Senior-Engineers/Well-Monitoring/Release_1_Well_Head_Unit/Tanzanian 1st  AWSOM installation.jpg

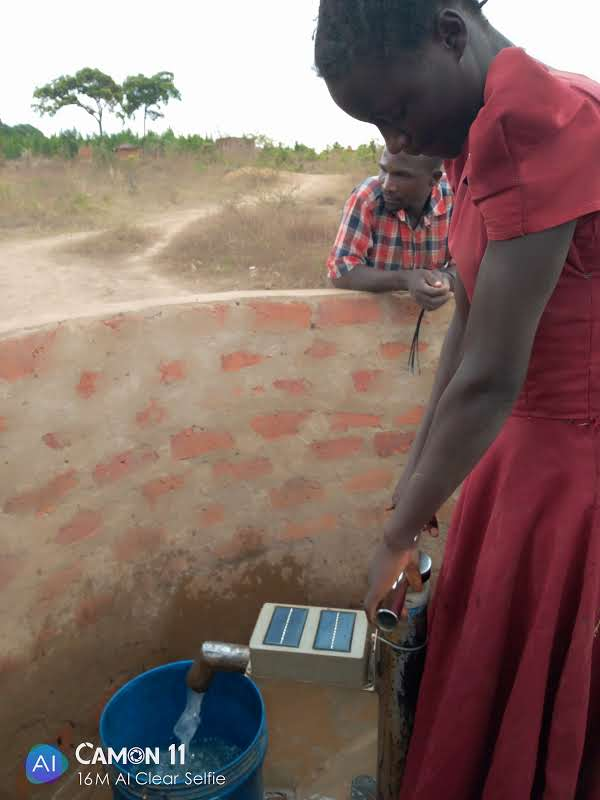
Release_1_Well_Head_Unit/Tanzanian 1st AWSOM installation.jpg
