Senior-Engineers/Well-Monitoring/Production_Base_Station/Photographs/Front_View_(Low_Res).jpg

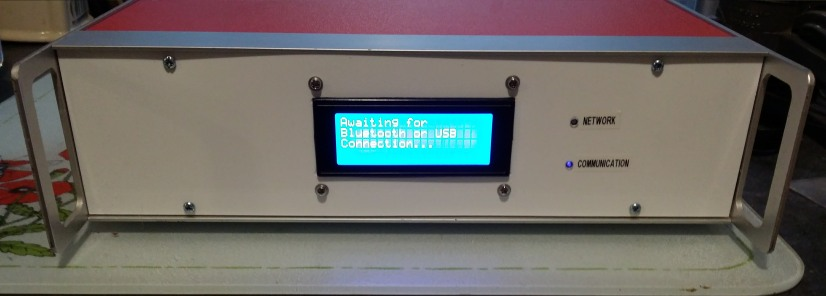
Production_Base_Station/Photographs/Front_View_(Low_Res).jpg
