Senior-Engineers/Well-Monitoring/Prototype_Base_Station/Index.pdf

Index.pdf | A list of files in this folder with a brief description
Prototype Base Station BOM.pdf | Details the "Bill of Materials" used to manufacture the Prototype Base Station
Prototype Base Station Conclusions.pdf | Details of how the development of the Prototype Base Station was completed
Prototype Base Station Design Requirement.pdf | Details of the Design Requirement
Prototype Base Station Schmatic.pdf | Details the Schematic of the Prototype Base Station
Prototype Base Station Inside.jpg | A photograph of the inside of the Case
Prototype Base Station LCD.jpg | A photograph showing the Liquid Crystal Display
Prototype Base Station Shield.jpg | A photograph of the Arduino UNO Shield showing the components
Prototype Base Station.jpg | A photograph of the Assembled Item
SMS_Master_1.5e.ino | The Arduino Sketch that controls the communication to/from the “Real World” and the SIM800L Mobile Phone Module
Stand Alone Usage Guide for Prototype Base Station.pdf | This Document outline the commands that can be sent to the “AWSOM Base Station” and the replies it returns.
