Senior-Engineers/Well-Monitoring/Release_1_Well_Head_Unit/AWSOM_Text_example.pdf

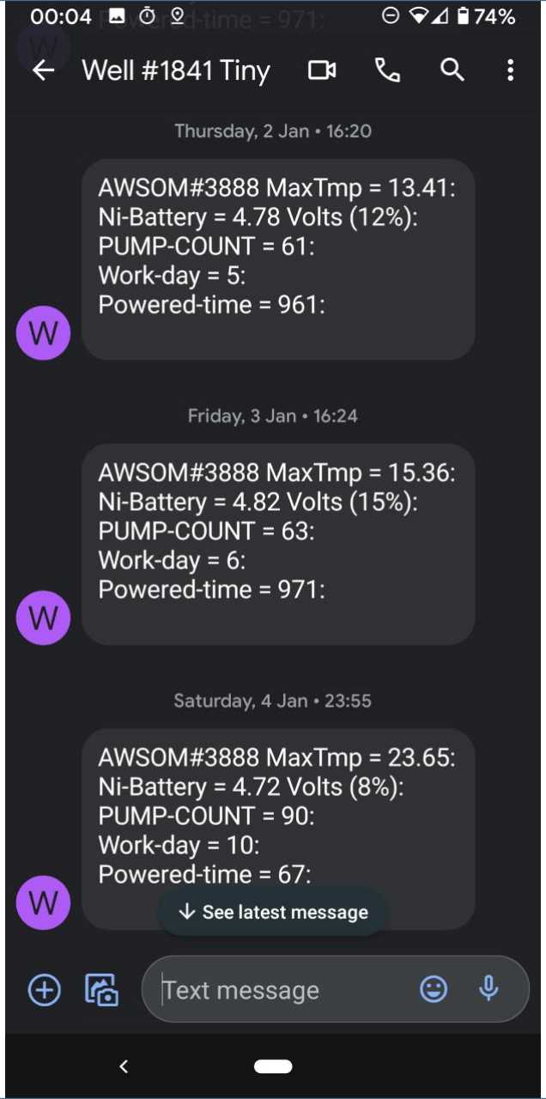
[picture p34: figure]

WellMonitoringService.co.uk | V20200517

# Texts Received from Test Well

### Notes:

- Missed 3 texts between 3rd and 4th of the month
- Reduced Powered-Time on the last text, on the 4th
- Low battery on the 4th
- High PUMP-COUNT with low Powered-Time on the 4th
- It was hot on the 4th
- The Well was checked at night on the 4th
- It was cool but sunny on the 3rd (http://www.wellmonitoringservice.co.uk/design.htm)
