Senior-Engineers/Well-Monitoring/Release_1_Well_Head_Unit/README.pdf

The files uploaded to this folder are to enable the manufacture of Release 1 of the Well Head Unit.

As part of the Sustainability Programme, it is possible to manufacture the items in Tanzania.

The PowerPoint Presentation (AWSOM Design v20200816.ppsx) provides an overview of the manufacturing process.

Please visit the Website at http://www.wellmonitoringservice.co.uk/design.htm where there are links to the YouTube Channel where you can view videos to enhance the static documents uploaded here.
