Senior-Engineers/Well-Monitoring/Release_1_Well_Head_Unit/RAW-DATA-SAMPLE.pdf

## AWSOMTM RAW DATA SELECTION 2019

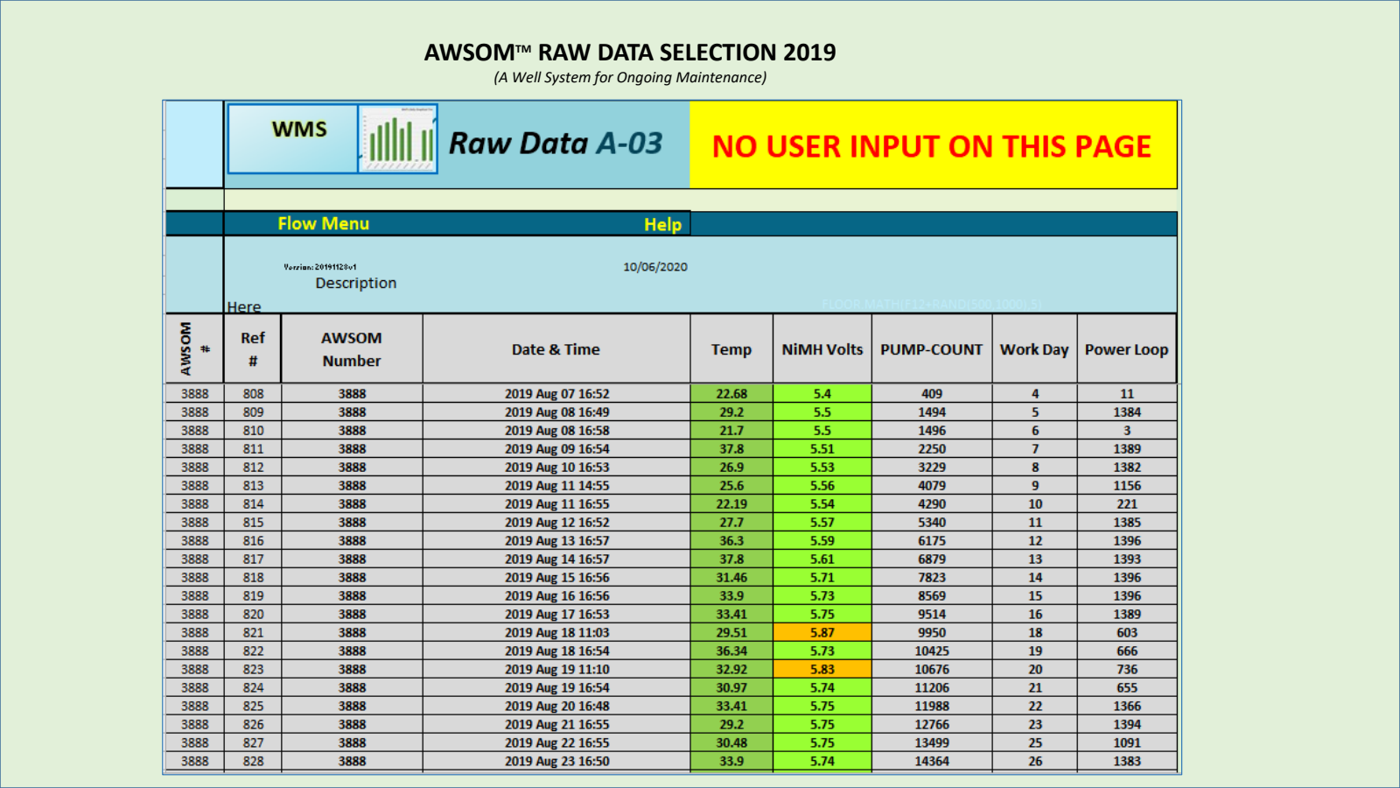
[picture p35: page 1]

(A Well System for Ongoing Maintenance)
