Senior-Engineers/Well-Monitoring/Prototype_Base_Station/Prototype Base Station Schmatic.pdf

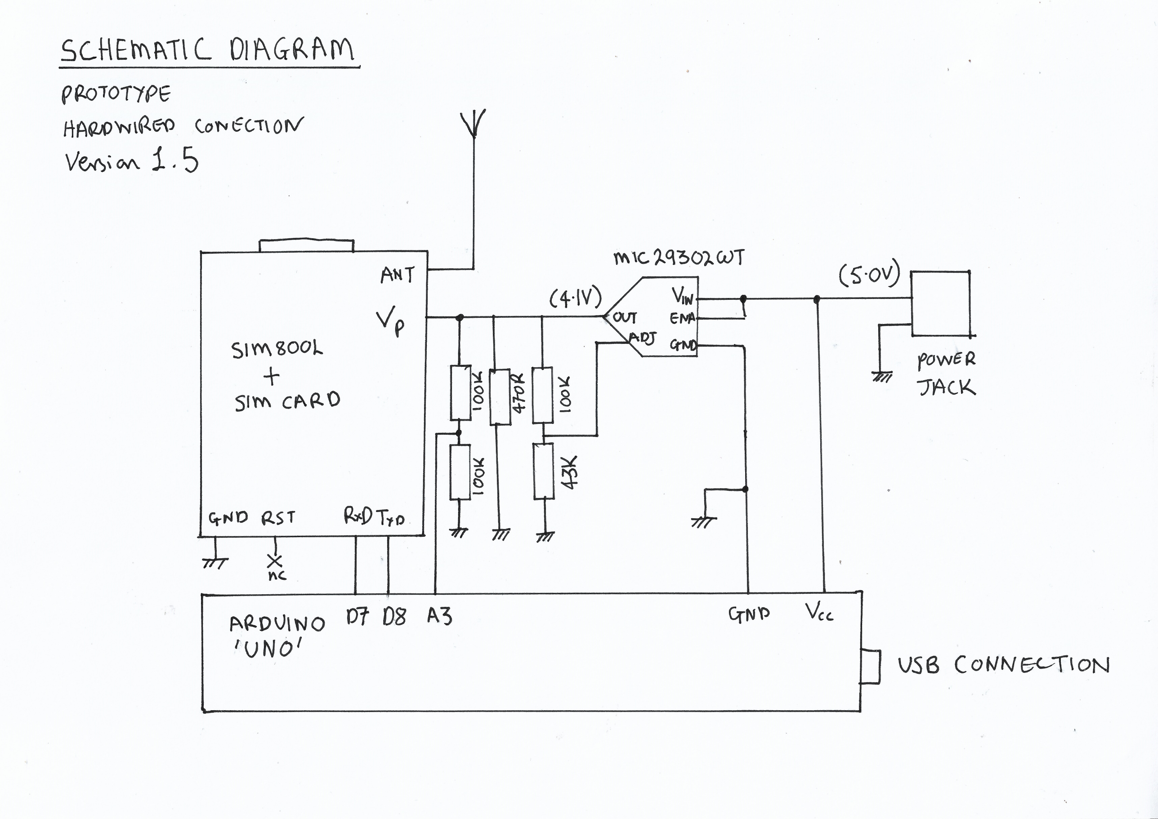
[picture p36: page 1]
