Senior-Engineers/Well-Monitoring/Production_Base_Station/Photographs/Rear_View_(Low_Res).jpg

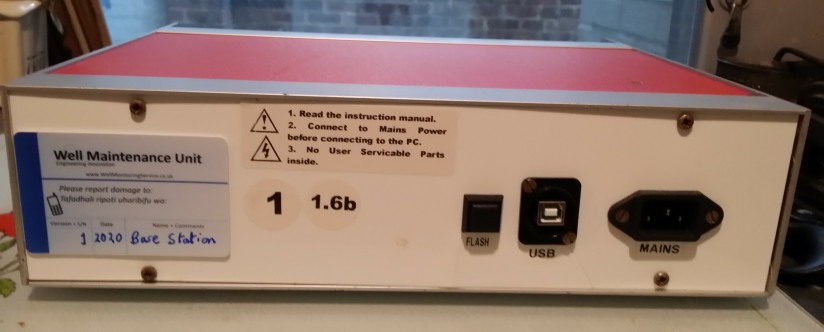
Production_Base_Station/Photographs/Rear_View_(Low_Res).jpg
