Senior-Engineers/Well-Monitoring/Prototype_Base_Station/Prototype Base Station Inside.jpg

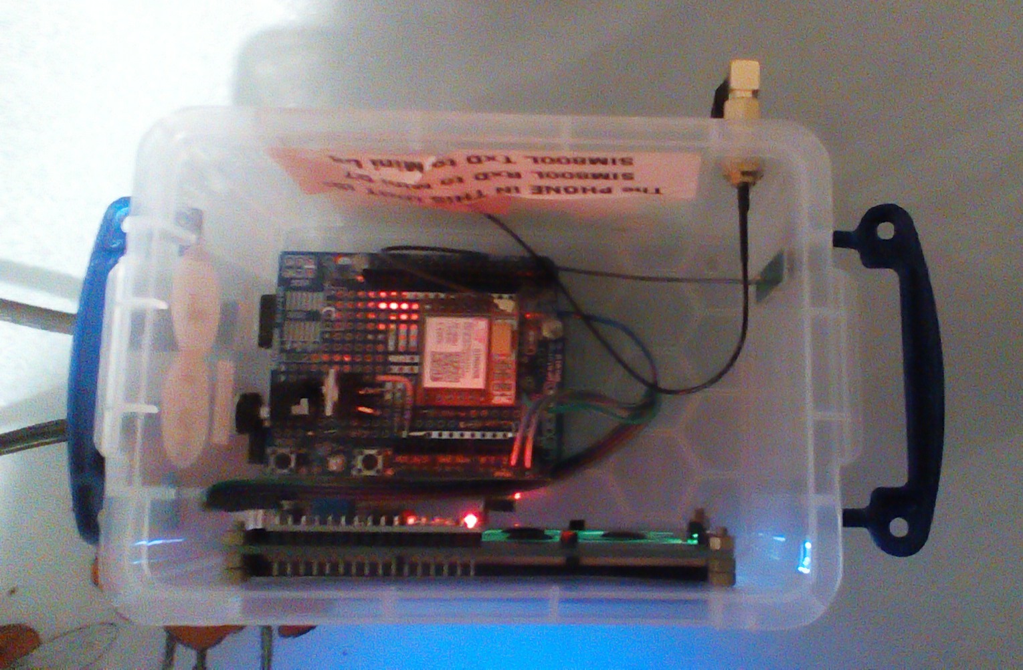
Prototype_Base_Station/Prototype Base Station Inside.jpg
