Senior-Engineers/Well-Monitoring/Prototype_Base_Station/Prototype Base Station LCD.jpg

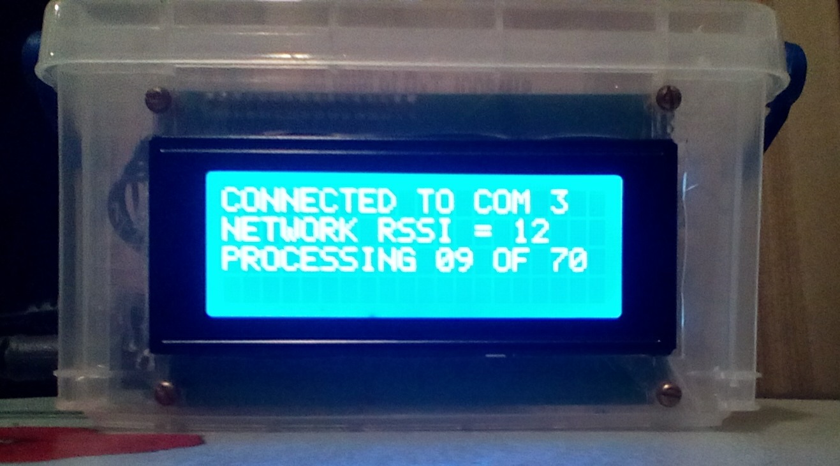
Prototype_Base_Station/Prototype Base Station LCD.jpg
