Senior-Engineers/Well-Monitoring/Prototype_Base_Station/Prototype Base Station Shield.jpg

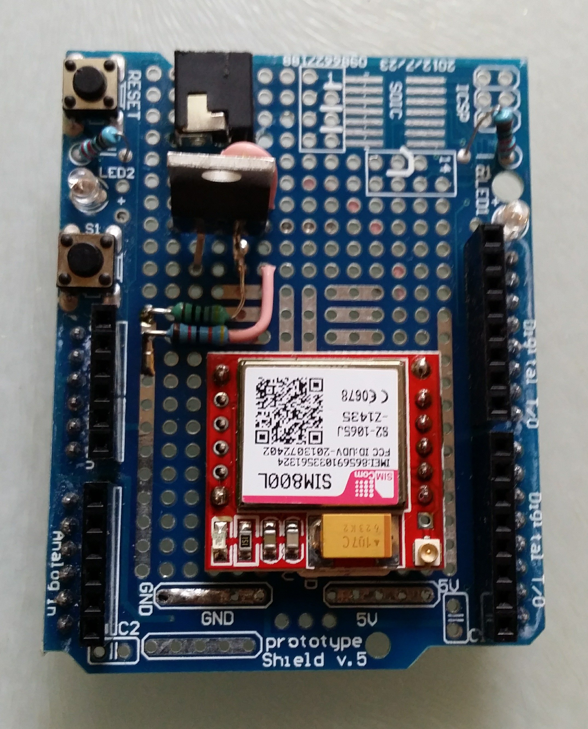
Prototype_Base_Station/Prototype Base Station Shield.jpg
