Senior-Engineers/Well-Monitoring/Prototype_Base_Station/Prototype Base Station.jpg

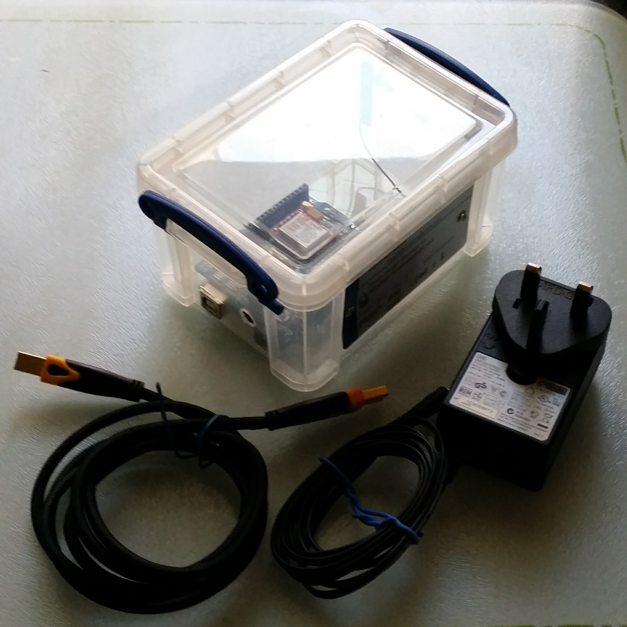
Prototype_Base_Station/Prototype Base Station.jpg
