Senior-Engineers/Well-Monitoring/Prototype_Base_Station/Prototype Base Station BOM.pdf

Ref | Description | Qty Price Each Sub Total Web link | Part No

na

Accessory Pack (Nuts; Bolts; Washers; Wire;
Solder; Glue; Paint; Conformal Coating etc.) | 1 | 5.00 £ | 5.00 £ | best guess?
X1 | Case | 1 £ | 9.75 £ | 9.75 Really Useful Box 0-7 Litre
µP1 | Arduino Module (UNO) | 1 £ 19.16 £ 19.16 Arduino UNO | RS 769-7409
µP2 | GSM GPRS Quad-Band Modules 2G | 1 £ | 9.99 £ | 9.99 SIM800L Quad-band Network Mini GPRS GSM Breakout Module: Amazon.co.uk: Electronics
PCB1 | Arduino UNO ProtoShield | 1 £ | 4.32 £ | 4.32 Arduino UNO ProtoShield
X2 | Raspberry Pi 3 (5v@2.5A) PSU | 1 £ | 7.74 £ | 7.74 Raspberry P1 3 Power Supply | RS 909-8126
X3 | Replacement Plug for X2 | 1 £ | 0.67 £ | 0.67 DC Power Plug | RS 771-9183
X4 | LED Light Pipe | 1 £ | 4.26 £ | 4.26 LED Light Pipe | RS 890-5782
CON1 | Power Connector | 1 £ | 0.26 £ | 0.26 DC power socket | RS 448-386
LCD1 | Liquid Crystal Display | 1 £ | 5.99 £ | 5.99 I2C Serial 20x4 LCD Module For Arduino UNO MEGA R3
µP3 | Voltage Regulator (MIC29302WT) | 1 £ | 1.96 £ | 1.96 Low-dropout Voltage Regulator - MIC29302WT) | RS 911-2893
R1 | Resistor 470R | 1 £ | 0.10 £ | 0.10 Through-hole Fixed Resistor 470R | RS 683-3749
R2 | Resistor 43K | 1 £ | 0.07 £ | 0.07 Through-hole Fixed Resistor 43K | RS 683-3695
R3 | Resistor 100K | 1 £ | 0.25 £ | 0.25 Vishay VR25 Series Axial Fixed Resistor 100kO ±5% 0.25W ±200ppm/°C | RS 683-5256
Component Count | 14 Cost | £ 69.52

Preffered source of components is "RS Components", then "Amazon" Prices checked at December 2020
