Senior-Engineers/Well-Monitoring/Release_1_Well_Head_Unit/AWSOM-Parts-List.pdf

| Valid up to May 2020
Required | Price (inc VAT)
Min RS
order Qty | RS Stock No. | Manuf. Part No. | Manufacturer | Description | Unit Price | Goods Value | Units
1 | 334-0424 | AGN2004H | Panasonic

### Panasonic PCB Mount Non-Latching Relay - DPDT, 4.5V dc Coil, 1A Switching Current (https://uk.rs-online.com/web/p/non-latching-relays/3340424/)

In stock for
FREE next
working day
delivery
£3.16 | £3.16 | 1 | £3.79
1 | 543-535 | 22-0239 | Vero Technologies | Vero Technologies Stripboard Cutter (https://uk.rs-online.com/web/p/stripboard-cutters/0543535/) | tools N/A | £13.89 | £13.89 | 0 | £0.00
1 | 153-3683 | BIM2006/IP-GY | RS PRO

RS PRO ABS Enclosure, IP54, Flanged, 210 x 112 x 61mm Grey (https://uk.rs-online.com/web/p/general-purpose-enclosures/1533683/)

In stock for
FREE next
working day
delivery
£11.34 | £11.34 | 1 | £13.61
1 | 917-5926 | NIMH 18670 2.4V 4A | RS PRO

### RS PRO 2.4V NiMH Rechargeable Battery Pack, 4Ah (https://uk.rs-online.com/web/p/rechargeable-battery-packs/9175926/)

2Available to
back order for
despatch
19/05/2019
£14.90 | £29.80 | 2 | £35.76
5 | 427-351 | TMP36GT9Z | Analog Devices

Analog Devices TMP36GT9Z,

### Temperature Sensor -40 → +125 °C

±3°C Voltage, 3-Pin TO-92 (https://uk.rs-online.com/web/p/temperature-sensors-humidity-sensors/0427351/)

In stock for
FREE next
working day
delivery
£1.10 | £5.51 | 1 | £1.32
1 | 488-1724 | M20-7823646 | HARWIN

### HARWIN 2.54mm Pitch 36 Way 1 Row Straight PCB Socket, Through Hole, Solder Termination (https://uk.rs-online.com/web/p/pcb-sockets/4881724/)

In stock for
FREE next
working day
delivery
£2.24 | £4.48 | 2 | £5.38
10 | 538-1433 | C322C104K5R5TA | KEMET

### KEMET 100nF Multilayer Ceramic Capacitor MLCC 50V dc ±10%

Through Hole C322C104K5R5TA (https://uk.rs-online.com/web/p/mlccs-multilayer-ceramic-capacitors/5381433/)

In stock for
FREE next
working day
delivery
£0.25 | £2.46 | 5 | £1.48
1 | 434-043 | 342

### Or 2mm thick from

E-Bay tbc (https://www.ebay.co.uk/itm/Aluminium-Sheet-1-5mm-2mm-3mm-Anodised-for-increased-durability-Satin-coloured/151707449719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)

### Natural Aluminium Sheet, 200mm Long, 2.71g/cm³, 300mm x 1.2mm (https://uk.rs-online.com/web/p/aluminium-sheets/0434043/)

In stock for
FREE next
working day
delivery
£9.83 | £9.83 | 1 | £11.80
1 | 547-3150 | M20-9993645 | HARWIN

HARWIN M20, 36 Way, 1 Row,

### Straight Pin Header (https://uk.rs-online.com/web/p/pcb-headers/5473150/)

In stock for
FREE next
working day
delivery
£1.90 | £3.80 | 2 | £4.56
1 | 918-1401 | SAS521 25ml | RS PRO

### RS PRO, 25 ml Yellow Cartridge

Acrylic Adhesive for Metal, Plastic (https://uk.rs-online.com/web/p/epoxy-resins-epoxy-adhesives/9181401/)

2Available to
back order for
despatch
04/06/2019
£10.39 | £20.78 | 2 | £24.94
1 | 494-124 | 494124 | RS PRO | RS PRO Silicone Grease 100 g Tube | N/A | £6.17 | £6.17 | 0 | N/A
1 | 292-6881 | AJB22 | CIF

### AJB22, Single-Sided Stripboard Bakelite, FR2 100 x 220 x 1.5mm (https://uk.rs-online.com/web/p/stripboards/2926881/)

In stock for
FREE next
working day
delivery
£7.60 | £7.60 | 1 | £9.12
10 | 712-7519 | AHEF100 | Littelfuse

### Littelfuse 1A Hold current, Radial

Leaded PCB Mount Resettable Fuse,

### 32V dc (https://uk.rs-online.com/web/p/resettable-wire-ended-fuses/7127519/)

In stock for
FREE next
working day
delivery
£0.32 | £3.23 | 1 | £0.39
10 | 463-274 | 1N5338BG | ON Semiconductor

### ON Semiconductor, 5.1V Zener Diode 5% 5 W Through Hole 2-Pin DO-15 (https://uk.rs-online.com/web/p/zener-diodes/0463274/)

In stock for
FREE next
working day
delivery
£0.27 | £2.74 | 2 | £0.66
5 | 189-6010 | 1757019 | Phoenix Contact

### Phoenix Contact, MSTB 2.5/2-5.08 PCB Terminal Block (https://uk.rs-online.com/web/p/pcb-terminal-blocks/1896010/)

In stock for
FREE next
working day
delivery
£1.48 | £7.41 | 2 | £3.56
5 | 189-6199 | 1755736 | Phoenix Contact

### Phoenix Contact, MSTBVA 2.5/ 2-G-5.08, 2 Way, 1 Row, Straight PCB Header (https://uk.rs-online.com/web/p/pcb-headers/1896199/)

In stock for
FREE next
working day
delivery
£0.49 | £2.47 | 2 | £1.19
100 | 914-1945 | A4MM203 010RS | RS PRO

RS PRO, M3 Countersunk Head,

### 10mm Stainless Steel Pozidriv A4 316 (https://uk.rs-online.com/web/p/machine-screws/9141945/)

1Available to
back order for
despatch
24/06/2019
£0.05 | £4.56 | 10 | £0.55
1 | 534-4939 | LP2950CZ-5.0/NOPB | Texas Instruments

### Texas Instruments LP2950CZ-5.0/NOPB, LDO Regulator, 100mA, 5

V, ±0.5% 3-Pin, TO-92 (https://uk.rs-online.com/web/p/low-dropout-voltage-regulators/5344939/)

In stock for
FREE next
working day
delivery
£2.02 | £2.02 | 1 | £2.42
1 | 813-2940 | SKT370-180-100 | ABB

### ABB, Spec-Kon Series Natural Nylon Cable Tie, 370mm x 3.6 mm (https://uk.rs-online.com/web/p/cable-ties/8132940/)

Available to
back order for
despatch when
stock is
available
£9.17 | £9.17 | 1 | £11.00
1 | 528-624 | SA6 | CAMDENBOSS

### CAMDENBOSS 210 x 110 x 60mm Gasket for use with 2000 Lugged IP65 Case (https://uk.rs-online.com/web/p/enclosure-accessories/0528624/)

In stock for
FREE next
working day
delivery
£1.29 | £1.29 | 1 | £1.55
50 | 700-0909 | SB160-E3/54 | Vishay

### Vishay 60V 1A, Schottky Diode, 2-

Pin DO-204AL SB160-E3/54 (https://uk.rs-online.com/web/p/rectifier-diodes-schottky-diodes/7000909/)

In stock for
FREE next
working day
delivery
£0.20 | £10.10 | 5 | £1.21
10 | 707-7745 | RS-Carbon-10k-5%-
0.25W | RS PRO

### RS PRO 10kΩ 0.25W Carbon Film Resistor ±5% (https://uk.rs-online.com/web/p/through-hole-fixed-resistors/7077745/)

In stock for
FREE next
working day
delivery
£0.11 | £1.08 | 1 | £0.13
20 | 707-7824 | RS-Carbon-100k-5%-
0.25W | RS PRO

### RS PRO 100kΩ 0.25W Carbon Film Resistor ±5% (https://uk.rs-online.com/web/p/through-hole-fixed-resistors/7077824/)

In stock for
FREE next
working day
delivery
£0.12 | £2.44 | 5 | £0.73
1 | Contingency | ano | misc | £10.00 | £10.00 | £10.00
1 | ebay | Computer | Arduino pro mini 5v 16MHz (https://www.ebay.co.uk/itm/Pro-Mini-Arduino-compatible-5V-16-Mhz-compatible-multipacks-UK-Seller/322491053190) | 5 days | £3.40 | £3.40 | 1 | £3.40
1 | ebay | Radar | Radar module RCWL-0516 (https://www.ebay.co.uk/itm/Microwave-Radar-Sensor-RCWL-0516-Switch-Module-Human-Induction-Arduino-PI/273010174370) | 3 days | £3.75 | £3.75 | 1 | £3.75
1 | ebay | Voltage Regulator

### Buck boost Regulator Module LM2596 3v-35v (https://www.ebay.co.uk/sch/i.html?_from=R40&_sacat=0)

| | | | | 60 days | £4.56 | £4.06 | 1 | £4.56
1 | ebay | Phone module | SIM800l Module with antenna UK (https://www.ebay.co.uk/itm/SIM800L-Module-With-Antenna-GSM-GPRS-SMS-For-Arduino-Raspberry-Pi-ESP-12-UK/263168705919) | | 3 days | £4.46 | £4.46 | 1 | £4.46
1 | ebay | Solar cells | 6v solar cells 90mm x 60mm (https://www.ebay.co.uk/sch/i.html?_osacat=0&_from=R40&_nkw=Solar+Panel+Module+Model%3A90X60mm+6V&_sacat=0) | variable | 48 days | £8.18 | £8.18 | 2 | £16.36
| | | | | | Total purchased | £199.18
1 | DHL | Shipping | Shipping (N/A Hand Carried) | | n/a | £59.00 | 'Hand carried' | 0 | £0.00

£177.66

Availability

# AWSOM Well Maintenance Unit Costed Parts List

Contact Details
andrewainger@hotmail.com
01582 469973
Product List

## (Pro-Rata) ORDER COSTS TOTAL:
