Senior-Engineers/Well-Monitoring/Release_1_Well_Head_Unit/AWSOM-Cct_DDiag.pdf

# AWSOMTM CIRCUIT DIAGRAM

## (A Well System for Ongoing Maintenance)

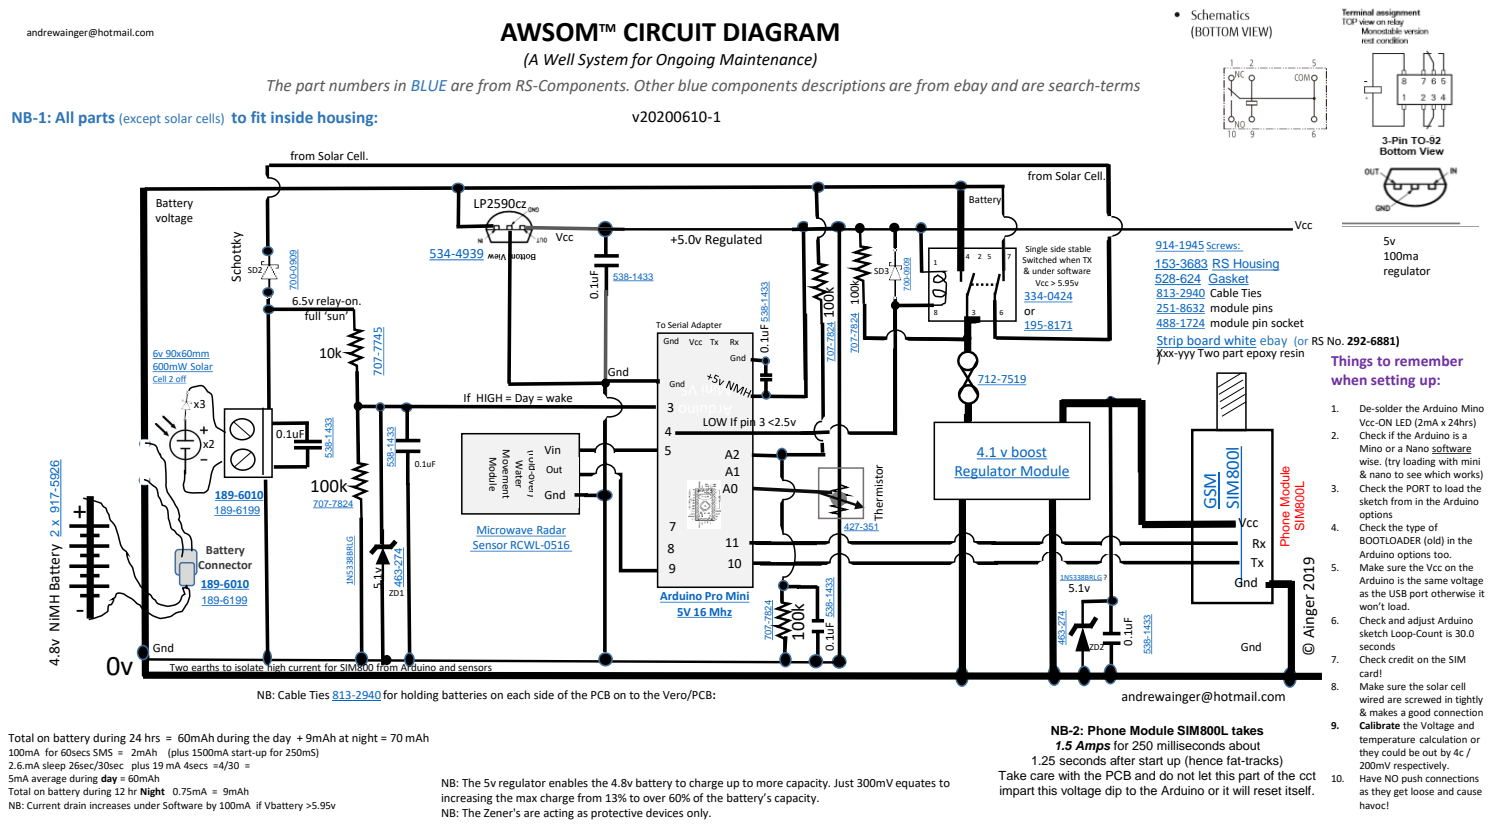
[picture p43: page 1]
4.8v NiMH Battery; (fold-over); Water; Movement; Module; Vin; Out; Gnd; GSM; SIM800l; Vcc; Thermistor; Battery voltage; LOW If pin 3 <2.5v; Battery; Out+; Battery Connector; 6v 90x60mm 600mW Solar Cell 2 off; +5.0v Regulated; Schottky; Microwave Radar Sensor RCWL-0516; The part numbers in BLUE are from RS-Components. Other blue components descriptions are from ebay and are search-terms 5.1v; 1N5338BRLG ?; 1N5338BRLG; © Ainger 2019; 6.5v relay-on. full ‘sun’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

andrewainger@hotmail.com

NB-1: All parts (except solar cells) to fit inside housing:

from Solar Cell.

914-1945 (https://uk.rs-online.com/web/p/machine-screws/9141945/?searchHistory={"enabled":true}) Screws: (https://uk.rs-online.com/web/p/machine-screws/9141945/?searchHistory={"enabled":true})
153-3683 RS Housing (https://uk.rs-online.com/web/p/general-purpose-enclosures/1533683/?searchTerm=153-3683)
528-624 (http://uk.rs-online.com/web/search/searchBrowseAction.html?method=searchProducts&searchTerm=528-624) Gasket (http://uk.rs-online.com/web/search/searchBrowseAction.html?method=searchProducts&searchTerm=528-624)
813-2940 (https://uk.rs-online.com/web/p/cable-ties/8132940/) Cable Ties
251-8632 (https://uk.rs-online.com/web/p/pcb-headers/2518632/?searchHistory={"enabled":true}) module pins
488-1724 (https://uk.rs-online.com/web/p/pcb-sockets/4881724/?searchHistory={"enabled":true}) module pin socket
Strip board white (https://www.ebay.co.uk/itm/Copper-stripboard-100-x-250mm-35-strip-x-97-hole-prototype-vero-board-CIC-21-119/114196166702) ebay (or RS No. 292-6881)
Xxx-yyy Two part epoxy resin

To Serial Adapter
Vcc

Things to remember
when setting up:

If HIGH = Day = wake

1. De-solder the Arduino Mino
Vcc-ON LED (2mA x 24hrs)
2. Check if the Arduino is a
Mino or a Nano software
wise. (try loading with mini
& nano to see which works)
3. Check the PORT to load the
sketch from in the Arduino
options
4. Check the type of
BOOTLOADER (old) in the

Arduino options too.
5. Make sure the Vcc on the
Arduino is the same voltage
as the USB port otherwise it
won’t load.
6. Check and adjust Arduino
sketch Loop-Count is 30.0
seconds
7. Check credit on the SIM
card!
8. Make sure the solar cell
wired are screwed in tightly
& makes a good connection
9. Calibrate the Voltage and
temperature calculation or
they could be out by 4c /
200mV respectively.
10. Have NO push connections
as they get loose and cause
havoc!

Arduino Pro Mini
5V 16 Mhz (https://www.ebay.co.uk/sch/i.html?_from=R40&_nkw=Arduino+Pro+Mini+5V+16+Mhz&_sacat=0)

Two earths to isolate high current for SIM800 from Arduino and sensors

NB: Cable Ties 813-2940 (https://uk.rs-online.com/web/p/cable-ties/8132940/) for holding batteries on each side of the PCB on to the Vero/PCB:

Total on battery during 24 hrs = 60mAh during the day + 9mAh at night = 70 mAh
100mA for 60secs SMS = 2mAh (plus 1500mA start-up for 250mS)
2.6.mA sleep 26sec/30sec plus 19 mA 4secs =4/30 =
5mA average during day = 60mAh
Total on battery during 12 hr Night 0.75mA = 9mAh
NB: Current drain increases under Software by 100mA if Vbattery >5.95v

NB-2: Phone Module SIM800L takes
1.5 Amps for 250 milliseconds about
1.25 seconds after start up (hence fat-tracks)
Take care with the PCB and do not let this part of the cct
impart this voltage dip to the Arduino or it will reset itself. (https://www.ebay.co.uk/itm/Smallest-SIM800L-GPRS-GSM-Phone-Module-Card-Board-Quad-band-Onboard-Antenna/301896039033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)

NB: The 5v regulator enables the 4.8v battery to charge up to more capacity. Just 300mV equates to
increasing the max charge from 13% to over 60% of the battery’s capacity.
NB: The Zener's are acting as protective devices only.
