Senior-Engineers/Well-Monitoring/Release_1_Well_Head_Unit/AWSOM-layout.pdf

# Well Maintenance Unit

# VERO BOARD Layout v20200607

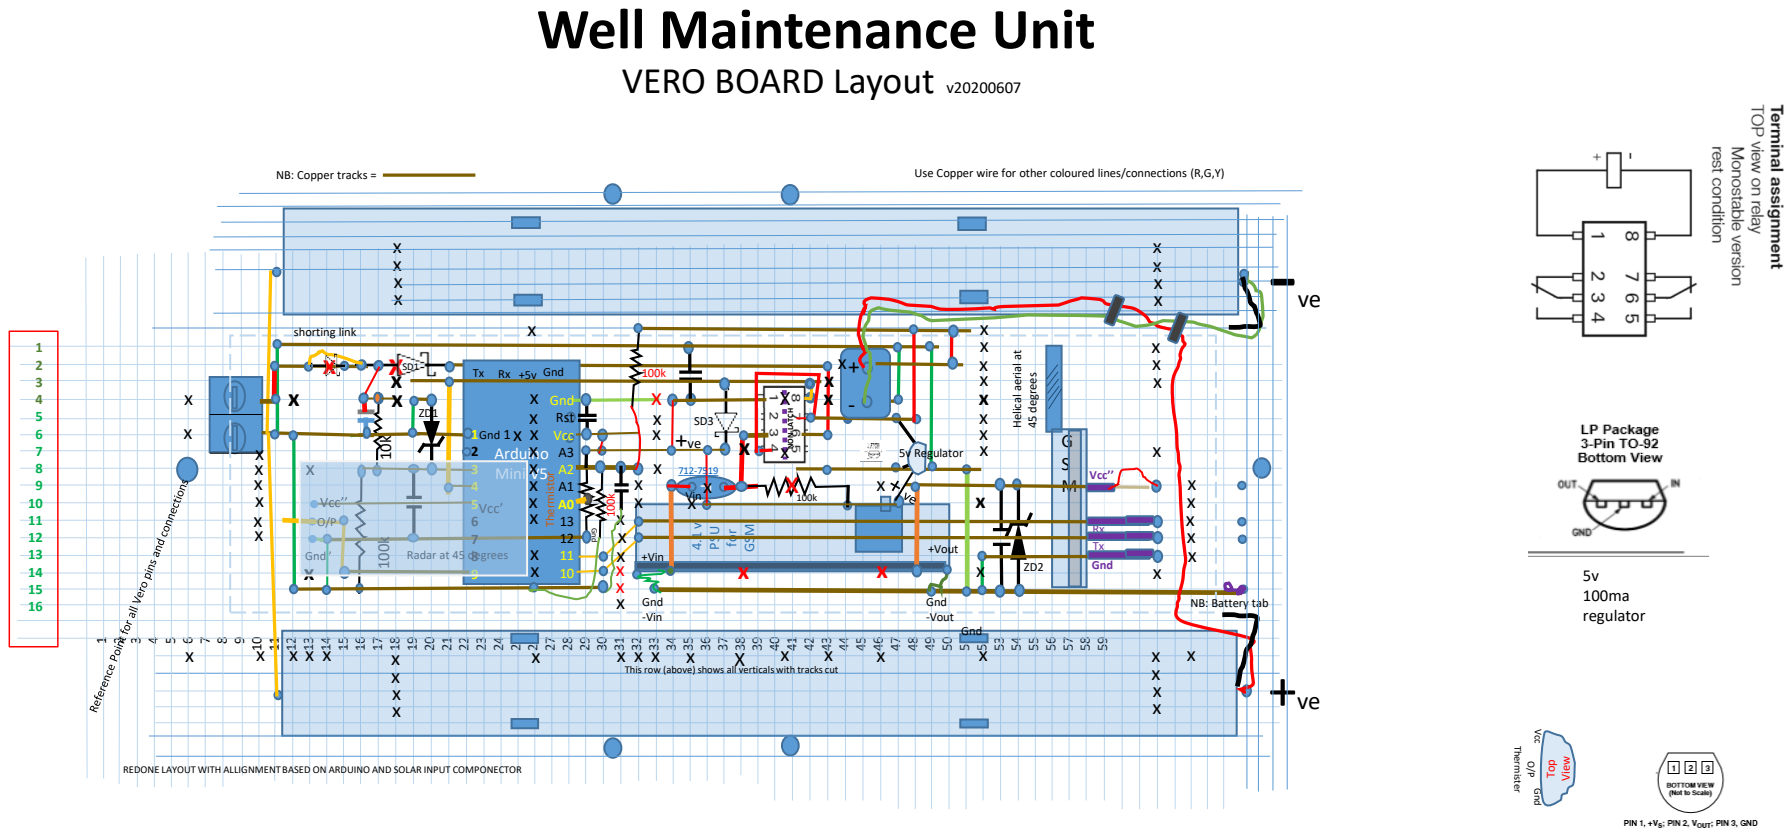
[picture p44: page 1]
PSU; for; GSM; NON-LATCH; +Vout +Vin; Gnd; Gnd -Vin; Gnd -Vout; Gnd O/P Vcc; Thermister; Top; View; 5v 100ma regulator; 45 degrees; Thermistor

NB: Copper tracks =

Use Copper wire for other coloured lines/connections (R,G,Y)

shorting link | x | | | x x x | SD1 | | | x | | | | | | | | | x | + - | 5v Regulator | | x x x x x x x | G S M | Vcc’’ | x x x x x | x | x x

Helical aerial at

x Vcc’’ O/P Gnd ’ | | | 1 Gnd 1 2 3 Vcc’ | Arduino Mini V5 | Rx | +5v x x x x x x x x x | Gnd Tx x x | Gnd Rst Vcc A3 A2 A1 A0 13 12 11 10 | 100k x x x | x | SD3 ZD1 F | x Gnd | X | x 100k | x | x

+ve 712-7519 (https://uk.rs-online.com/web/p/resettable-wire-ended-fuses/7127519/?searchTerm=712-7519)

x x | x

Radar at 45 degrees | 4 5 6 7 8 9

Vin | x | x

x | ZD2 | Rx Tx Gnd

NB: Battery tab

This row (above) shows all verticals with tracks cut

REDONE LAYOUT WITH ALLIGNMENT BASED ON ARDUINO AND SOLAR INPUT COMPONECTOR
