Senior-Engineers/Well-Monitoring/Release_1_Well_Head_Unit/BOARD-DIMENTIONS.pdf

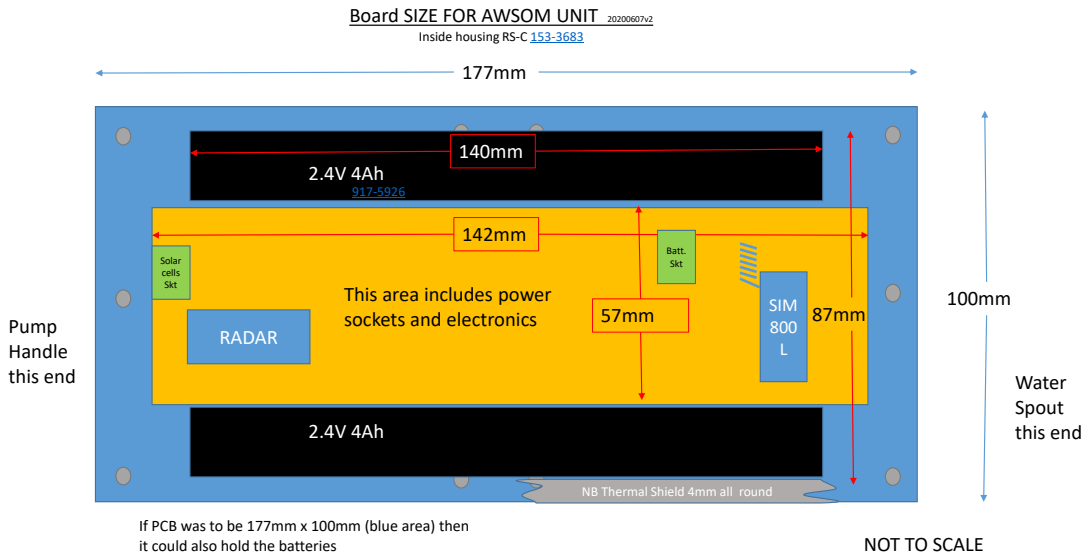
[picture p45: page 1]
Solar cells Skt; Batt. Skt; RADAR; Water Spout this end; Pump Handle this end; SIM 800 L

Board SIZE FOR AWSOM UNIT 20200607v2

Inside housing RS-C 153-3683 (https://uk.rs-online.com/web/p/general-purpose-enclosures/1533683/?searchHistory={"enabled":false})

This area includes power
sockets and electronics

NB Thermal Shield 4mm all round

If PCB was to be 177mm x 100mm (blue area) then
it could also hold the batteries

NOT TO SCALE
