Senior-Engineers/Well-Monitoring/(list of files, drawings)

Other design files:
Production_Base_Station/Production Base Station (3).pcb
